GauriK58/Audio-Amplifier-Project/Report_Team9.pdf

# Audio Amplifier Design

Gauri Krishnan
International Institute of Information Technology Hyderabad, India
gauri.krishnan@students.iiit.ac.in 2024102073

Sukeerthi Kattamuri
International Institute of Information Technology Hyderabad, India
sukeerthi.kattamuri@students.iiit.ac.in 2024102074

Abstract—This project presents the design and simulation of a multi-stage audio amplifier capable of amplifying low-level input audio signal. The system is designed to achieve an overall voltage gain of approximately 500 for input signals in the range of 10–20 mV peak-to-peak. The amplifier consists of a differential amplifier used as a pre-amplifier for noise reduction and initial gain, followed by a common emitter stage that provides the majority of the voltage amplification. A bandpass filter is then used to restrict the signal to the human audible frequency range. Finally, a power amplifier stage increases the signal power to effectively drive the load.

I. INTRODUCTION

The primary function of the audio amplifier is to amplify a low-magnitude input audio signal and deliver a sufficiently strong output to drive a speaker. The design specifications require an input signal in the range of 10–20 mV peak-topeak to achieve an overall voltage gain of 500.
To meet this requirement, the amplifier is implemented using multiple stages. The first stage is a differential amplifier that serves as the pre-amplifier. Its main purpose is to reduce noise present at the input while providing an initial level of voltage gain. This improves signal quality before further amplification. The second stage consists of a common emitter (CE) amplifier. This stage provides the majority of the voltage gain required to meet the overall gain specification of 500. After sufficient amplification, the signal is passed through a bandpass filter. This filter restricts the frequency range to the human audible spectrum (20 Hz to 20 kHz), removing unwanted low-frequency and high-frequency components. The final stage is the power amplifier. Its function is to increase the signal power to a level capable of driving the specified load effectively.
Thus our final circuit consists of:
- Mic Circuit
- Pre-Amplifier
- CE Amplifier
- Bandpass Filter
- Power Amplifier
- Speaker
The design specifications are given below:

TABLE I: Audio Amplifier Design Specifications

Parameter | Specification
Input Voltage (Microphone) | 10–20 mV (peak-to-peak)
Input Frequency Range | 20 Hz – 20 kHz
Voltage Gain | 500
Power Output | ≈ 1.5 W
Load Impedance | ≈ 10 Ω

II. MICROPHONE CIRCUIT
The microphone can be modeled as a resistor that changes on the basis of the intensity of the incoming sound. These changes are converted into voltage variations so the resulting signal can be given as input to the pre-amplifier stage.

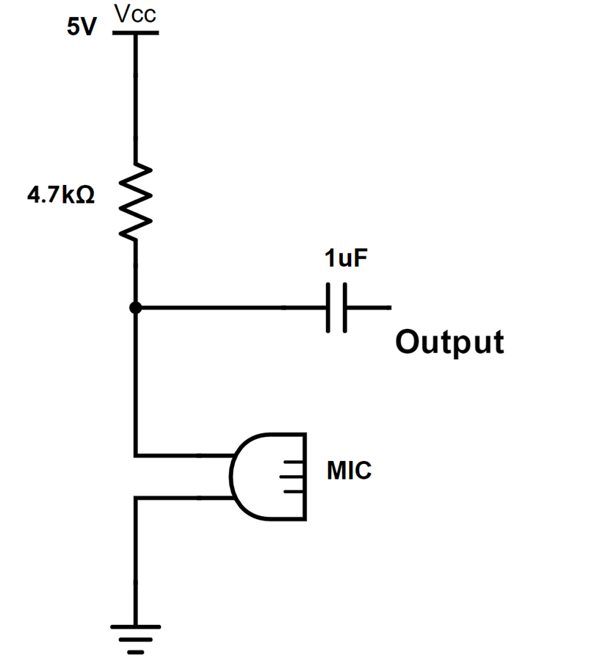
[picture p1: figure]

Fig. 1: Mic Circuit Diagram

III. PRE - AMPLIFIER STAGE The pre-amplifier stage amplifies the difference between two input voltages while suppressing any signal common to both inputs. Since the microphone input signal is very weak, it is highly susceptible to noise. If noise is not removed at this stage, it will continue to be amplified in the subsequent stages. Therefore, the pre-amplifier must provide good noise rejection along with moderate voltage gain.
In our implementation, the input signal is applied to the first transistor of the differential pair, while the second transistor is grounded. This configuration allows for differential operation and improved noise immunity.
A. Gain Derivation
Consider the small-signal model of the BJT differential amplifier. For small-signal operation:

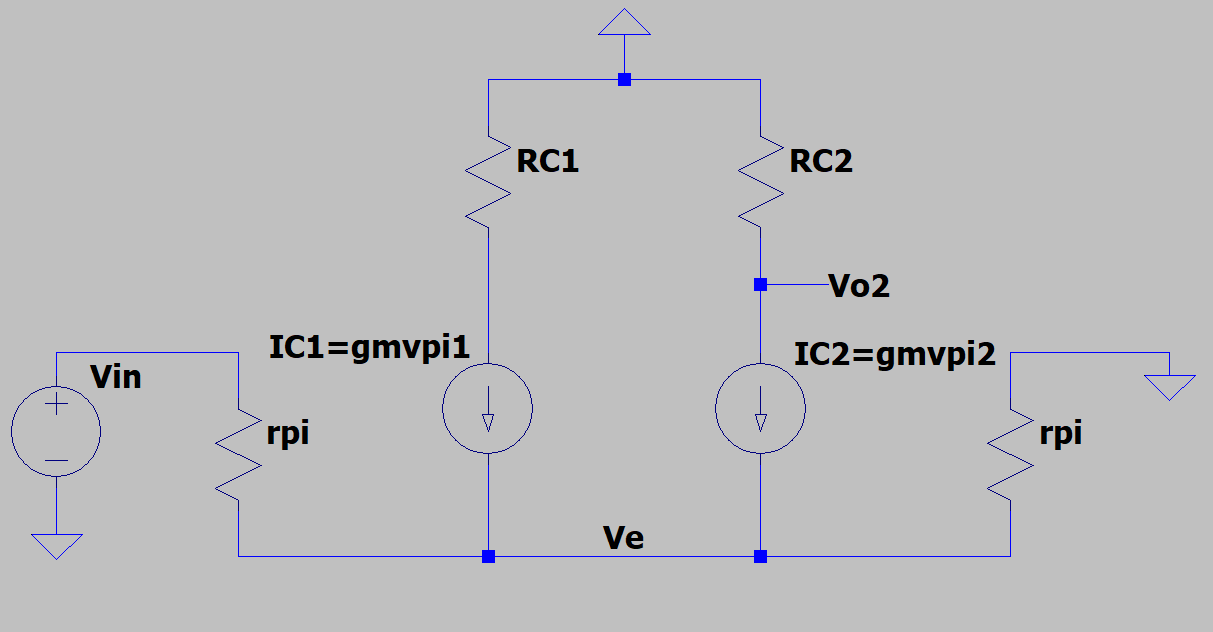
[picture p2: figure]

Fig. 2: Pre-Amplifier Small Signal Model

ic1 = gmvπ1, | ic2 = gmvπ2

From the input loop,

Vin − vπ1 + vπ2 = 0

⇒ Vin = vπ1 − vπ2 | (1)

Applying KCL at the common emitter node:

vπ1
rπ

+

vπ2
rπ

+ gmvπ1 + gmvπ2 = 0
gm +

1
rπ
(vπ1 + vπ2) = 0
⇒ vπ1 = −vπ2 | (2)

The output is taken from one collector:

vo2 = −gmvπ2RC

Using (1) and (2), substitute vπ2 = −

Vin
2

:

⇒ vo2 = gm

Vin
2
RC

Now,
Av =

vo

Vin

=

gmRC
2
Since

re =

1
gm

Av =

RC
2re

If an external emitter resistance RE is added:

Av =

RC
2(re + RE)
B. Target Gain and Parameter Calculation Target gain, Av = 20

We assume:
RC = 5 kΩ

Using DC bias condition:

VCC − IC RC = VCE

Taking:

VCE =

1
2

VCC

IC =

2.5
5 × 10³

= 5 × 10⁻⁴ = 500 µA

Tail current:
IT = 2IC = 1000 µA

Tail resistance:
−RT IT + 5 = 0

RT =

5
1000 µA = 5 kΩ

Small-signal emitter resistance:

re =

VT
IC

≈ 52 Ω

Differential gain:

Ad =

RC
2(re + RE)

Substituting target gain:

20 =

5000
2(52 + RE)

RE = 72 Ω

After iterating values, we end up with RE = 55Ω and RT = 2.15 kΩ

C. Common Mode Rejection Ratio (CMRR)
The performance of the differential amplifier is evaluated using differential gain, common-mode gain, and the Common Mode Rejection Ratio (CMRR). A high CMRR indicates effective suppression of common-mode noise.

a) Theoretical Expressions:
- Differential Gain (Ad) represents the amplification of the difference between the two input voltages.
- Common-mode Gain (Acm) represents the amplification of signals common to both inputs. Ideally, this should be very small.
- Common Mode Rejection Ratio (CMRR) is defined as:

CMRR = 20 log
Ad

Acm

b) Measured Values: The following values were obtained from circuit simulation:
- Differential Gain

Ad =

430.17
20

= 21.5

- Common Mode Gain:

Acm = 2.268

CMRR = 20 log
21.5

2.268
= 19.53 dB

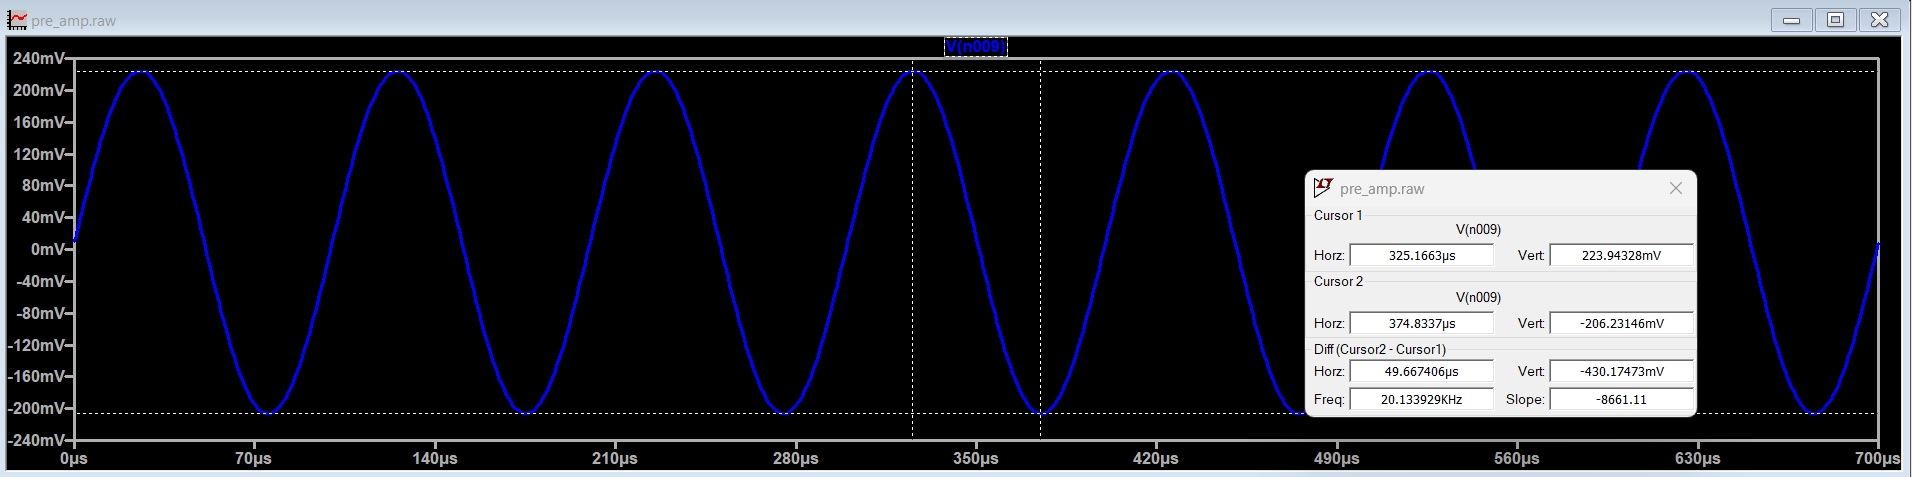
[picture p3: figure]

Fig. 3: Pre-Amp Differential Gain (Ad)

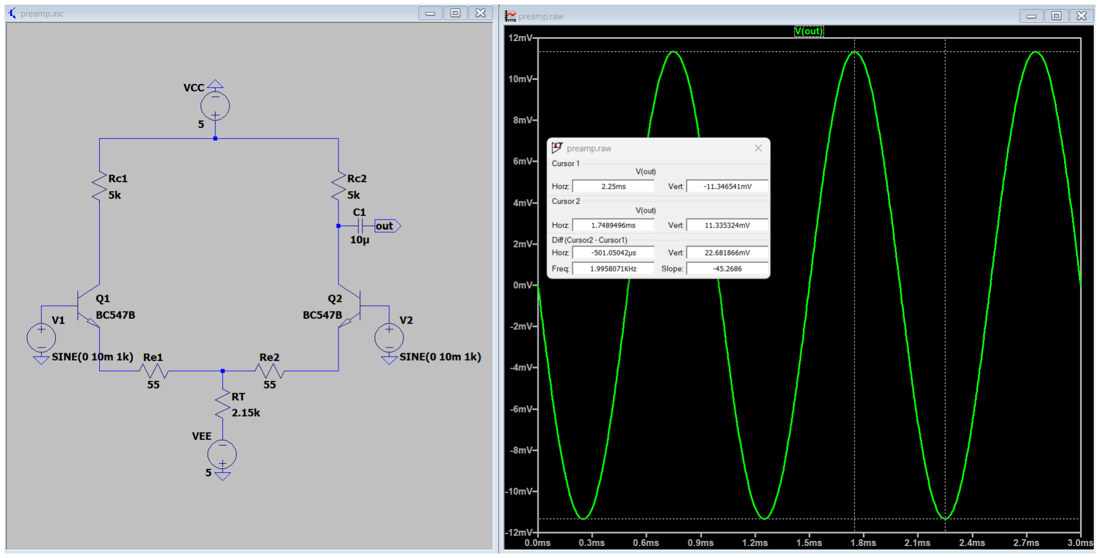
[picture p4: figure]

Fig. 4: Pre-Amp Common Mode Gain(Ac)

D. Input and Output Impedance Analysis

The pre-amplifier should have:

- High input impedence (Rin), so that it does not load the microphone source.
From Fig 14a, input impedence = 1
2.362 = 42.33kΩ
- Low output impedence (Rout), so that it can effectively drive the next stage.
From Fig 14b, output impedence = 1V 200.48µA = 4.9kΩ

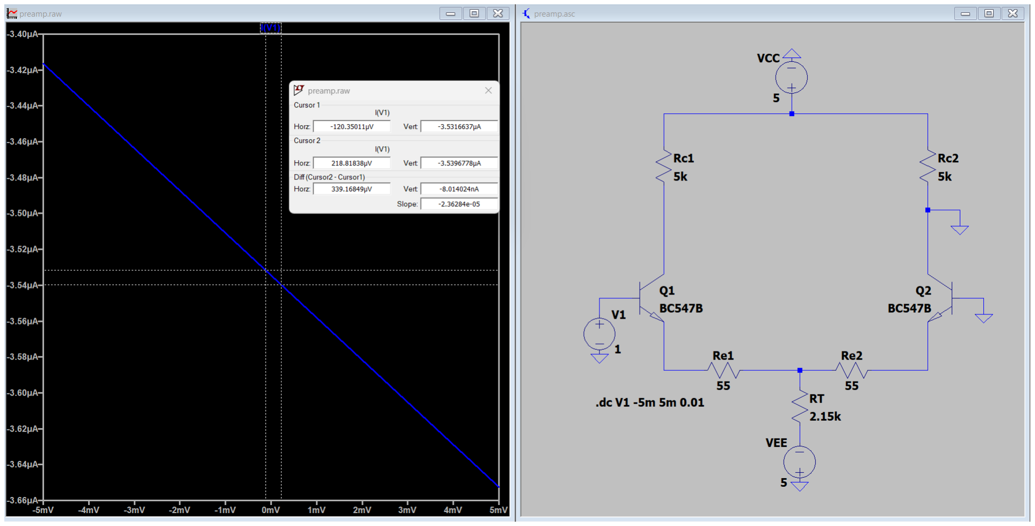
[picture p5: figure]

(a) Input Impedance Measurement

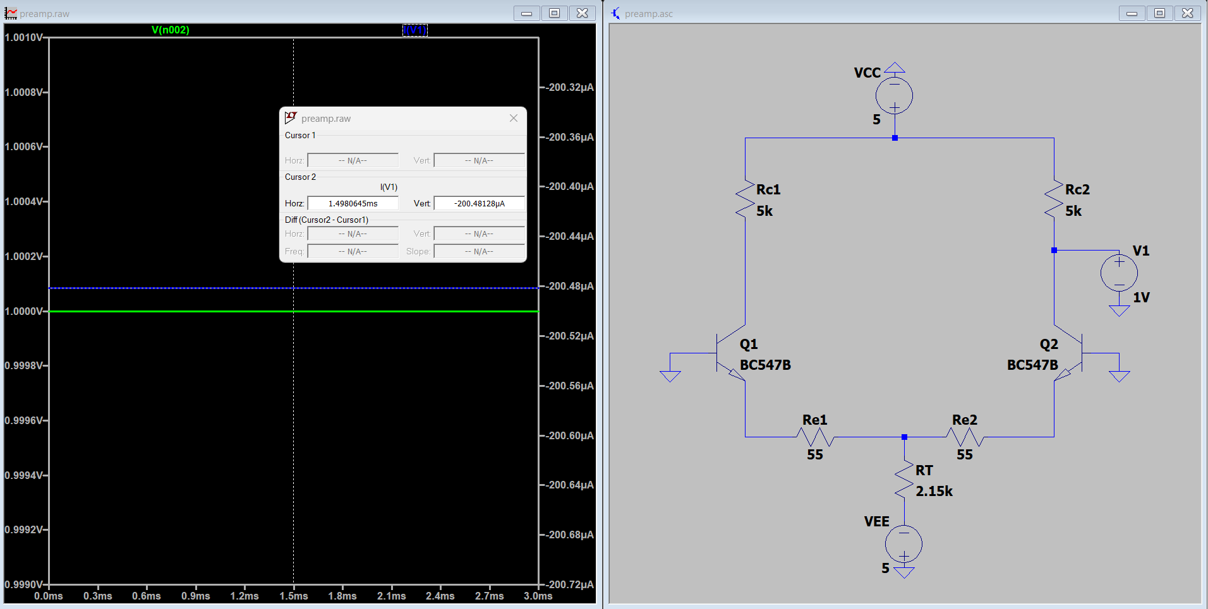
[picture p6: figure]

(b) Output Impedance Measurement

Fig. 5: Pre-amplifier impedance measurements

E. Waveforms

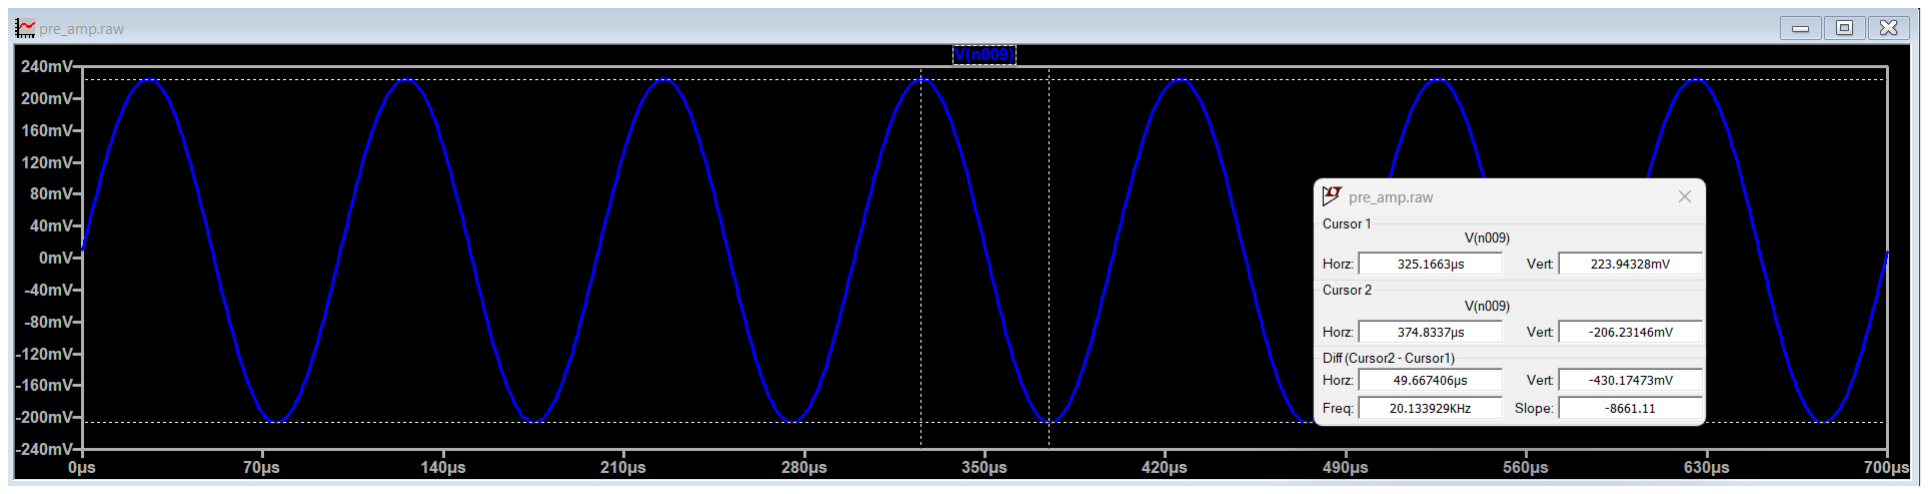
[picture p7: figure]

Fig. 6: Pre-Amp Gain

Fig 7a shows Pre-Amp output in hardware when it is not connected to the rest of the circuit.

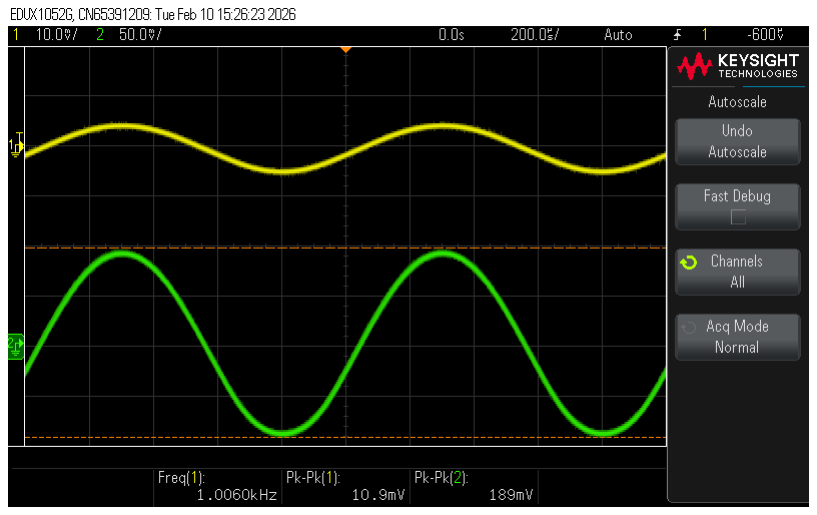
[picture p8: figure]
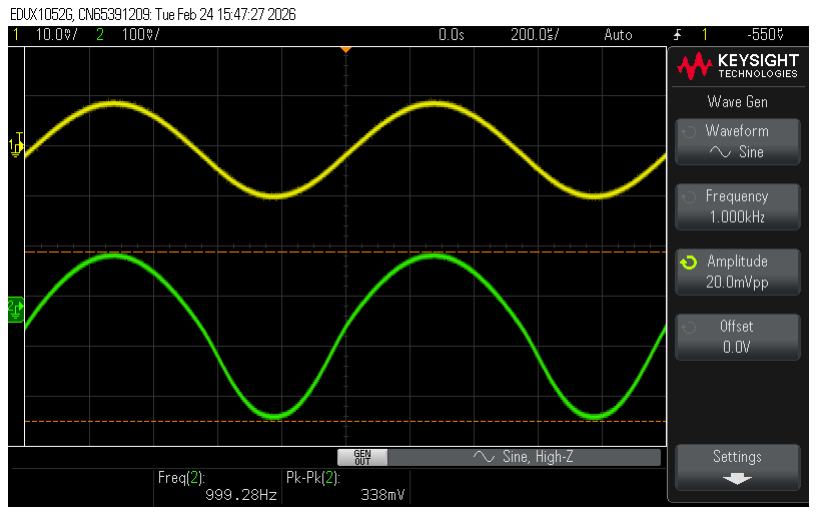
[picture p9: figure]

(a) Output for (for 10mV input) | (b) Output in full circuit

Fig. 7: Pre-amplifier output in hardware

IV. GAIN STAGE

A. Small Signal Gain Calculation

Consider the small-signal model of the CE amplifier.

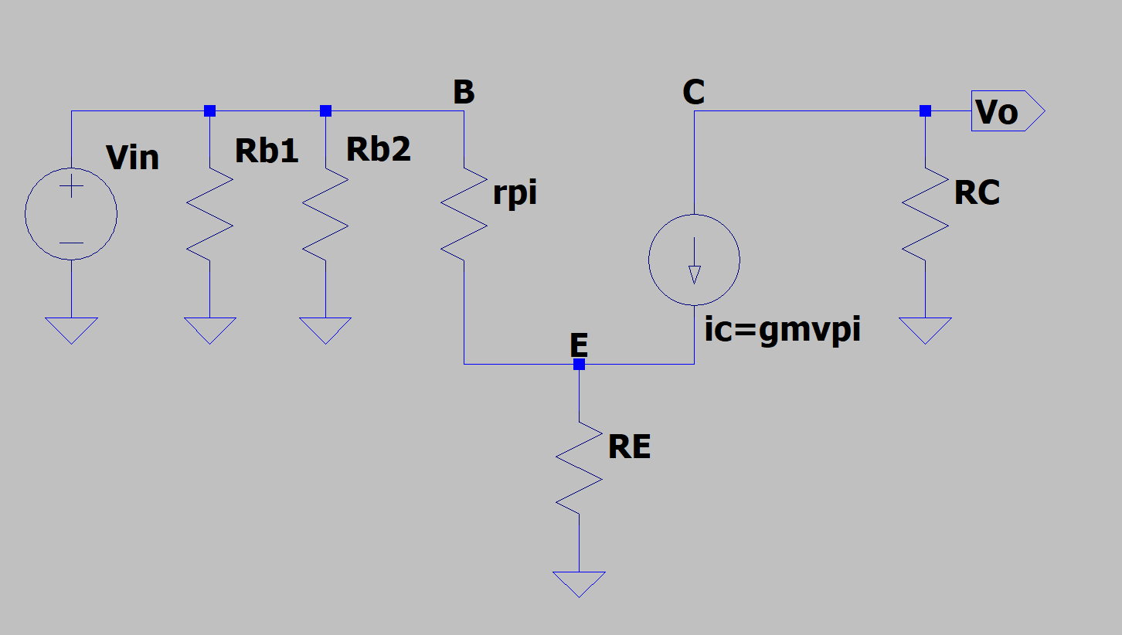
[picture p10: figure]

Fig. 8: CE Small Signal Model

Since the output current flows through the collector resistor,

io = −ic

⇒ vo = −icRC = −gmvπRC | (1)

Applying KVL at the input loop,

vin = vπ + vE

Also,
vE = iERE

Taking iE ≈ iC ,

vin = vπ + icRE = vπ + gmvπRE

⇒ vin = vπ(1 + gmRE)

Thus

vπ =

vin
1 + gmRE

Substituting into equation (1),

vo = −gmRC

vin
1 + gmRE

Therefore the voltage gain is

Av =

vo

vin

=

−gmRC
1 + gmRE

Since

re =

1
gm

⇒ Av = −

RC
re + RE
B. Target Gain and Parameter Calculation
The overall gain requirement of the amplifier is approximately 500. However, because of the 0.6V drop across the BE junction of the transistor, the voltage swing reduces. Achieving a gain of 500 is nearly impossible so we aim for a gain of 450. The pre-amplifier stage already provides a gain of approximately 20 so the CE amplifier stage is designed to provide a gain of about 25 so that the combined gain meets the required specification.

Target gain, Av = 25
We assume RC = 5.6 kΩ

The small signal gain of the CE amplifier is

|Av| =

gmRC
1 + gmRE

Using the relation

gm =

ic
VT

⇒ |Av| =

icRC
VT + icRE

Rearranging,

AvVT + AvicRE = icRC

AvVT = ic(RC − AvRE)

ic =

AvVT
RC − AvRE

(1)

For proper transistor operation, the condition

VC − VE > 0.7V

must be satisfied.
Considering iE ≈ iC ,

VC = VCC − icRC

VE = iERE

Substituting,

VCC − icRC − icRE − VEE > 0.7

10 − ic(RC + RE) > 0.7

9.3 > ic(RC + RE)

Substituting equation (1):

AvVT
RC − AvRE

(RC + RE) < 9.3

Using Av = 25, VT ≈ 26 mV 0.65(5.6k + RE) 5.6k − 25RE

< 9.3

Solving, we obtain

| RE < 207.5 Ω

Now for calculating the values of resistances RB1

and RB2
,
From the gain expression,

Av = 25 =

| 5.6k ic 26 × 10⁻³ + 20ic

25(26 × 10⁻³ + 20ic) = 5600ic

0.650 + 500ic = 5600ic

ic =

0.65
600

≈ 1 mA

Using the base-emitter loop, and taking ie ≈ ic

VB − 0.7 − ieRE + 5 = 0

VB − 0.7 − 0.2 + 5 = 0

VB = −4.1 V

VCC − VB

RB1

=

VB − VEE

RB2

Thus, RB1

: RB2 = 10.11:1 The values we took after trial and error are RB1 = 200kΩ RB2 = 18kΩ
Thus, the initial values taken were RC = 5.6kΩ and RE = 200Ω. However, once we connected the following stages, there was a drop in gain due to loading. To account for this, we increased gain in the CE stage by increasing RC to 7.2kΩ. This induced clipping, and to combat this, we changed RE to 270Ω.

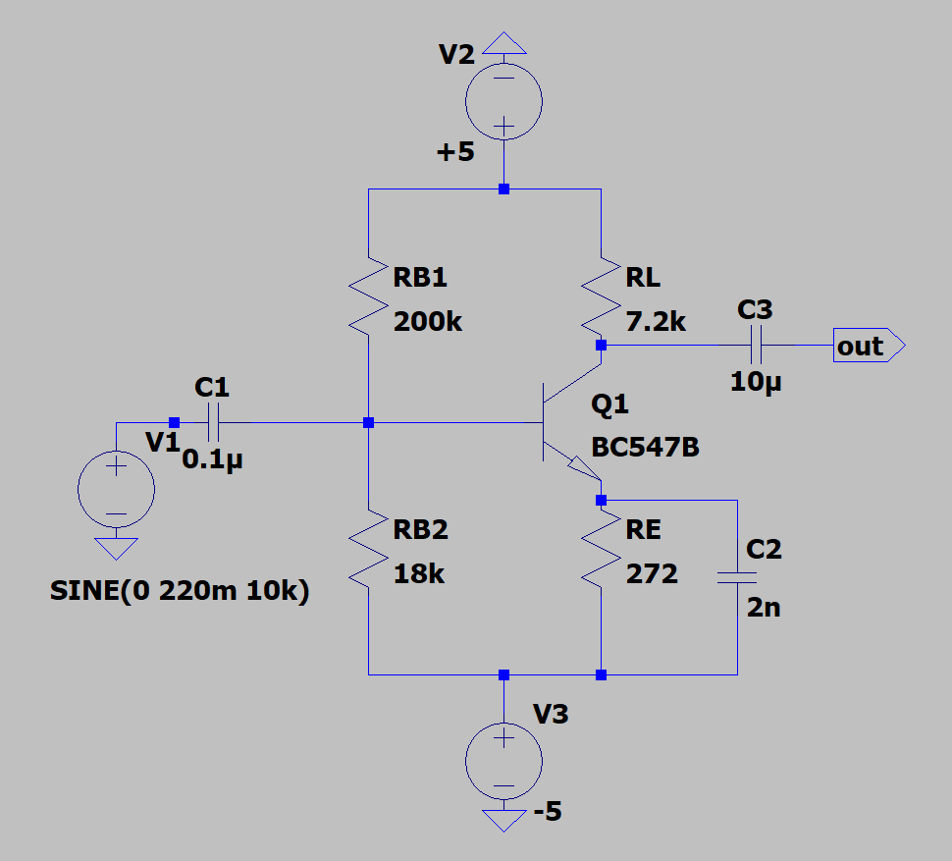
[picture p11: figure]

Fig. 9: CE circuit

C. Biasing Design and Active Region Verification

The base of the transistor is biased using the voltage divider formed by the resistors RB1 and RB2. This voltage divider sets a stable DC bias voltage VB at the base terminal. The chosen resistor values ensure that the base voltage can be fixed at a desired level so that the transistor operates in the correct region.

VB =

VCC RB2 + VEERB1

RB1 + RB2

By plugging in the values, we obtain the bias point in the circuit as −4.17V From the simulations, we measure VC = 0.5V and VE = −4.8V , which shows that the transistors are in the active region of operation.

D. Waveform Verification
1) Simulation: Comparing the gain after CE stage alone and with the full circuit:
2) Hardware: Fig 12 shows the output of CE-Amp in the final circuit (with all stages connected).

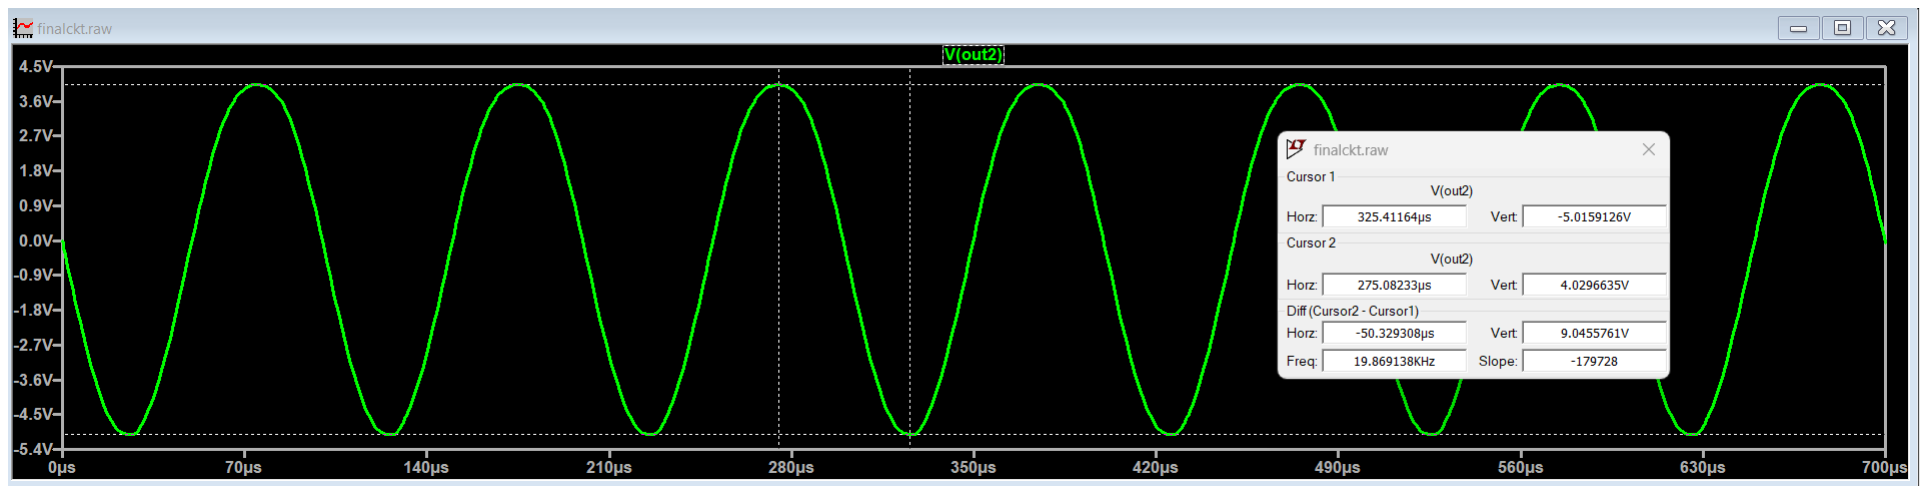
[picture p12: figure]

Fig. 10: PreAmp and Gain stage integration.

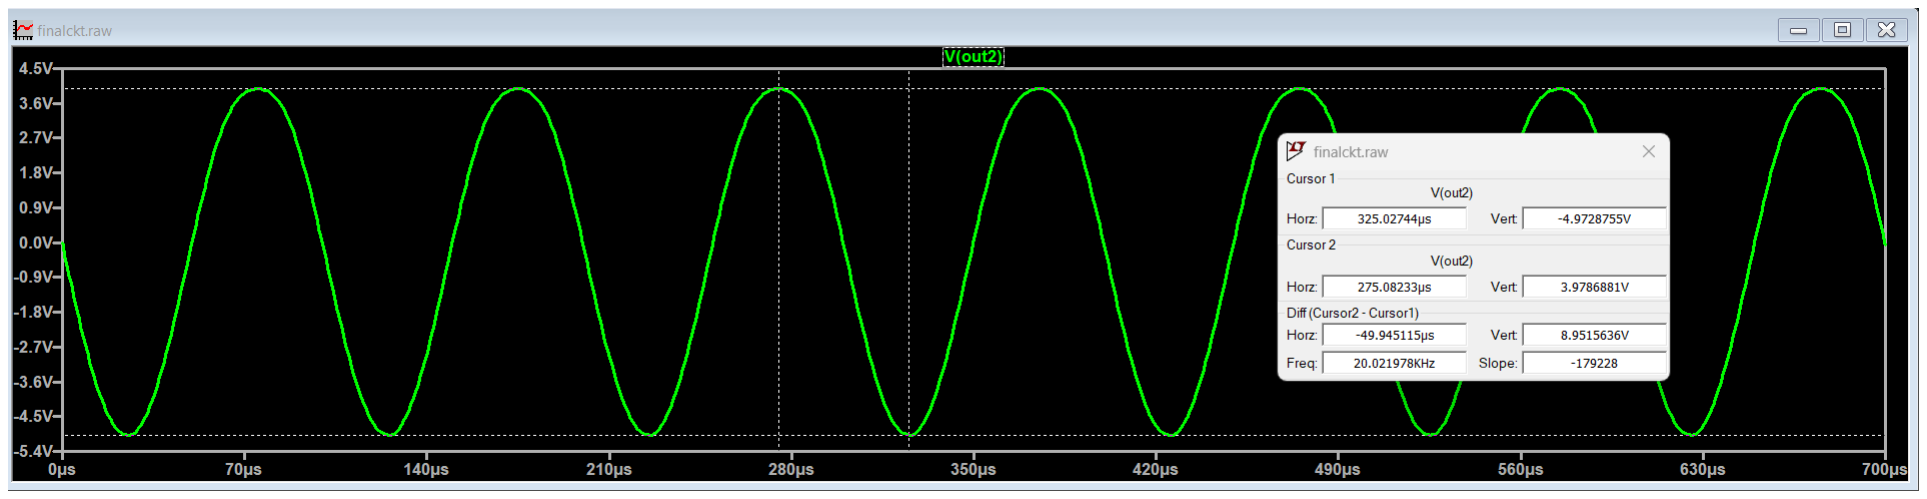
[picture p13: figure]

Fig. 11: PreAmp and CE stage gain with full circuit.

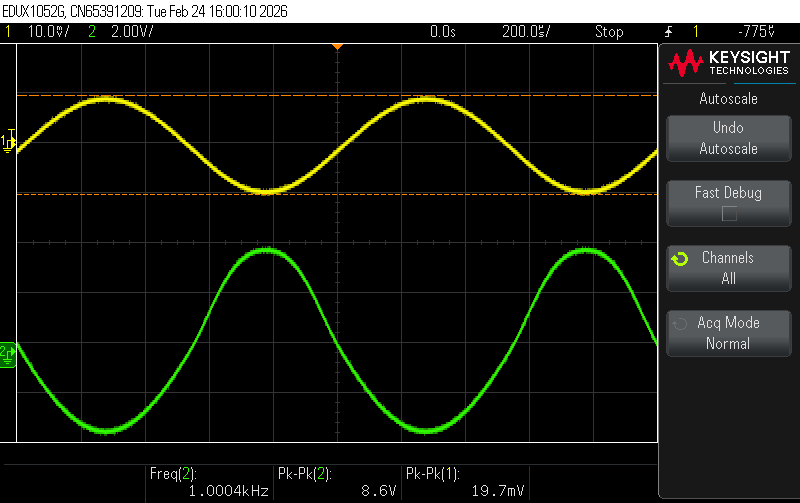
[picture p14: figure]

Fig. 12: Gain after CE stage in the fully connected circuit.

V. FILTER STAGE

The bandpass filter is used to remove noise and unwanted frequency components that lie outside the audible range. The desired passband is from 20 Hz to 20 kHz, ensuring that only frequencies within the human hearing range are allowed to pass while signals outside this range are attenuated. The cutoff frequencies are selected such that there is a small margin around the passband to account for the −3 dB cutoff points of the filter. Although the desired passband of the audio amplifier is the human audible range of 20 Hz to 20 kHz, the filter was designed with cutoff frequencies slightly beyond this range to ensure that there is no attenuation at 20 Hz and 20 kHz. As a result, frequencies near 20 Hz and 20 kHz remain within the flat region of the passband, maintaining consistent audio quality across the desired frequency spectrum.

An active bandpass filter configuration is used in this design, which employs operational amplifiers rather than relying solely on passive components. The use of an active filter provides better control over the gain and allows a sharper and more well-defined frequency response compared to passive bandpass filters.

A. AC Response Derivation

The active bandpass filter is implemented using an operational amplifier in the inverting configuration. The input network (R1, C1) forms the high-pass section, while the feedback network (R2, C2) forms the low-pass section.

Since an ideal op-amp has very high input impedance, no current flows into the input terminals. Therefore, the currents through the input and feedback networks are equal:

Vin − V

−
Z1

=

V

− − Vout
Z2

For an ideal op-amp operating with negative feedback,

V

− = V
+ = 0

Thus,

Vout

Vin

= −

Z2
Z1

The impedances of the input and feedback networks are

Z1 = R1 +

1
sC1

Z2 =

R2
1 + sR2C2

Substituting into the gain expression,

Vout

Vin

= −

R2
1 + sR2C2

·

sC1
sR1C1 + 1

Therefore, the transfer function of the active bandpass filter is

H(s) = Vout

Vin

=

−sR2C1
(1 + sR2C2)(1 + sR1C1)

Letting s = jω,

H(jω) = | −jωR2C1 (1 + jωR2C2)(1 + jωR1C1)

For the midband region where

1
R1C1
| < ω <
| 1 R2C2

the transfer function simplifies to

| Av ≈ − R2 R1

Since the filter stage is designed to have unity gain,

| R2 = R1

From the simulation, the lower cutoff frequency is approximately 9.5 Hz and the upper cutoff frequency is approximately 38.4 kHz, corresponding to the −3 dB points.

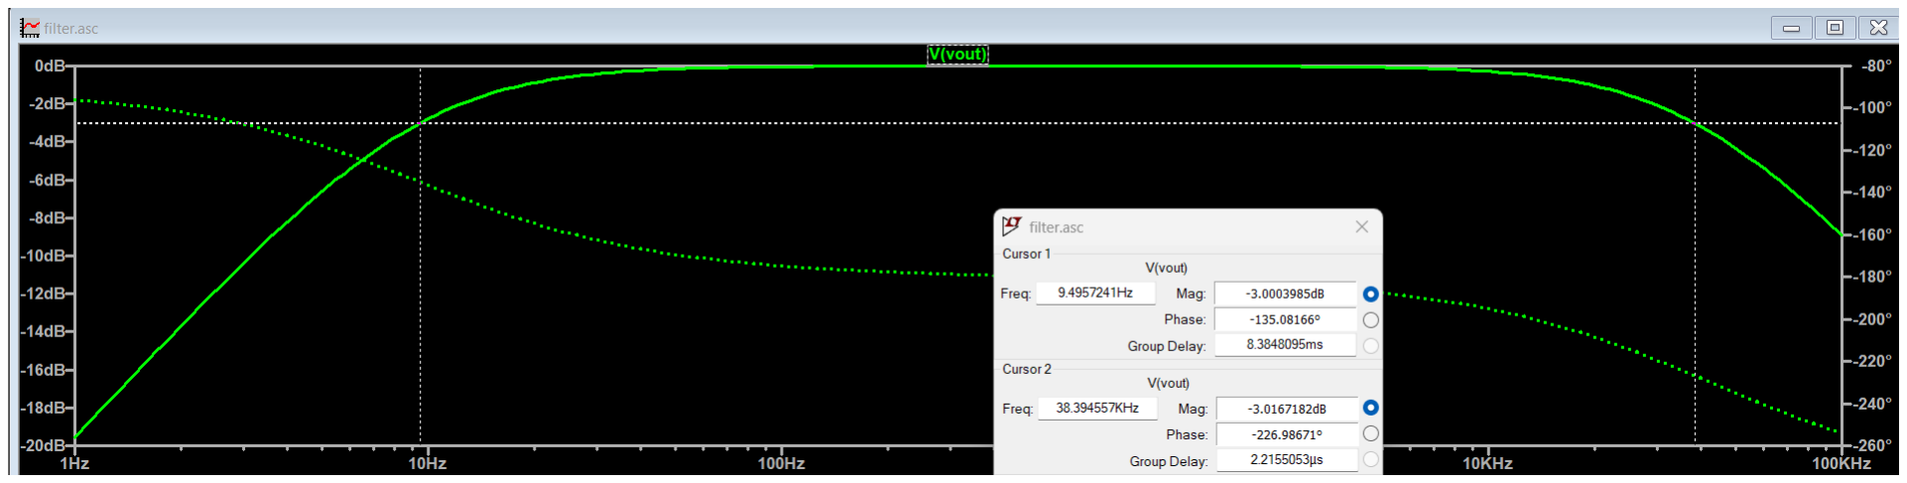
[picture p15: figure]

Fig. 13: 0dB Gain of Filter

B. Plots

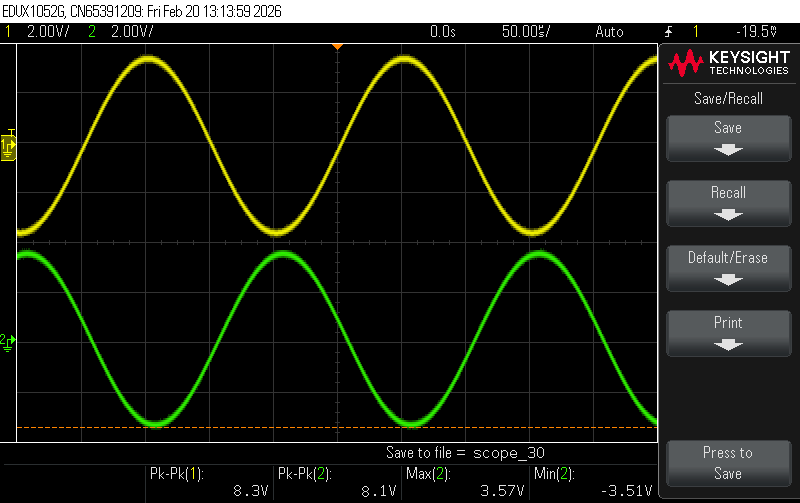
[picture p16: figure]
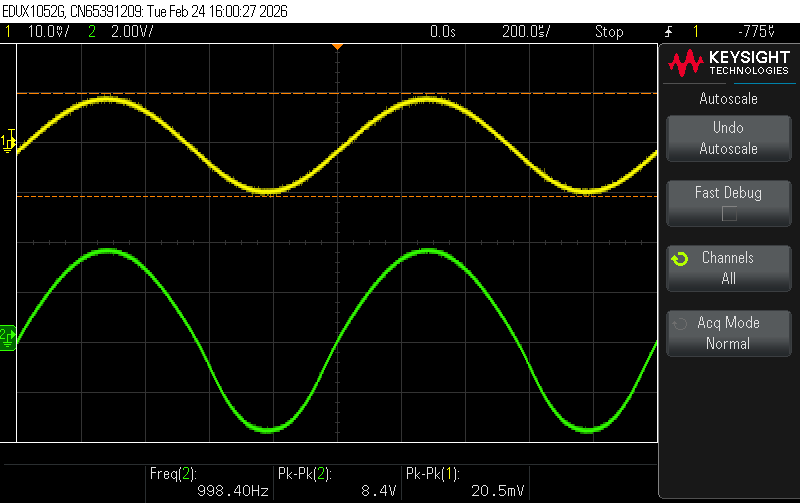
[picture p17: figure]

(a) Output of Filter Stage alone | (b) Output in full circuit

Fig. 14: Pre-amplifier output in hardware

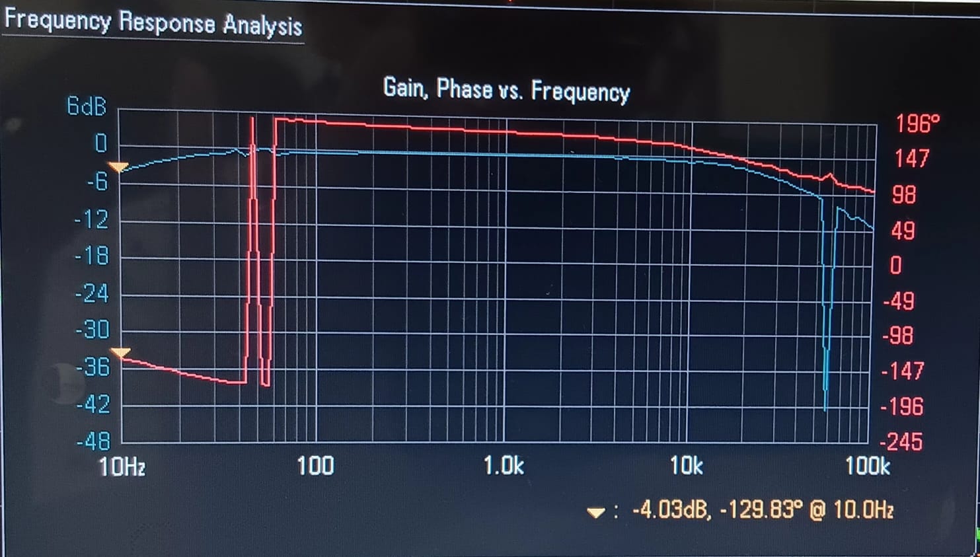
[picture p18: figure]

Fig. 15: Bodeplot showing 0dB gain (Hardware)

VI. POWER AMPLIFIER

A. Class AB Configuration and Biasing

A Class AB power amplifier is used in the final stage to provide sufficient current after the filter stage to drive the speaker load. AB configuration is chosen is because it combines the advantages of both class A and B configurations.

Class A has low distortion but high power dissipation since the transistor is conducting throughout. Class B amplifiers on the other hand, save power since they conduct only during the positive half of the cycle, but result in crossover distortion during the period when both the transistors are off. To solve these, class AB amplifier removes this distortion by slightly biasing both transistors so that they conduct for a little more than half of the cycle.

Power transistors TIP31C and TIP32C are used for more tolerance. To ensure that the bases of the transistors are biased such that remain slightly forward biased, diodes are used since they have a voltage drop of about 0.7 V when they are forward biased.
By placing diodes in the biasing path, a nearly constant voltage difference is established between the bases of the two transistors. As a result, the transition between the positive and negative halves of the signal is smooth, which eliminates crossover distortion in the output.
B. Unity Gain
Considering the small signal emitter resistance re and load resistance RL, Av =

RL
RL+re
Since RL ≫ re, Av ≈ 1.
C. Parameter Values
The two biasing resistors ensure that the transistors are slightly forward biased, which helps prevent crossover distortion in the output stage. The capacitors act as AC coupling capacitors that block any DC offsets while allowing the AC signal to pass to the next stage. The values are chosen based on the high-pass cutoff frequency given by fc =

1
2πRC where R is the effective input resistance seen by the capacitor and C is the coupling capacitor value.

Initially, the resistor values were chosen as 1 kΩ. However, this caused loading on the power supply during the hardware implementation. This occurred because the resistors form a current path between the supply rails through the diode biasing network. With such low resistance values, a relatively large current flows through this path, resulting in excessive current draw from the power supply. When the resistor values were increased to 4.7 kΩ, the bias current decreased, preventing the power supply from overloading while still maintaining the required biasing conditions. This was the final resistance value used in the hardware circuit.

The selected capacitor value of 0.2 µF ensures that the audio signal passes through the stage without significant attenuation while maintaining stable DC biasing of the circuit. Equal values were used for the resistors and capacitors in both branches to maintain symmetrical biasing and ensure equal amplification during the positive and negative half cycles of the signal.

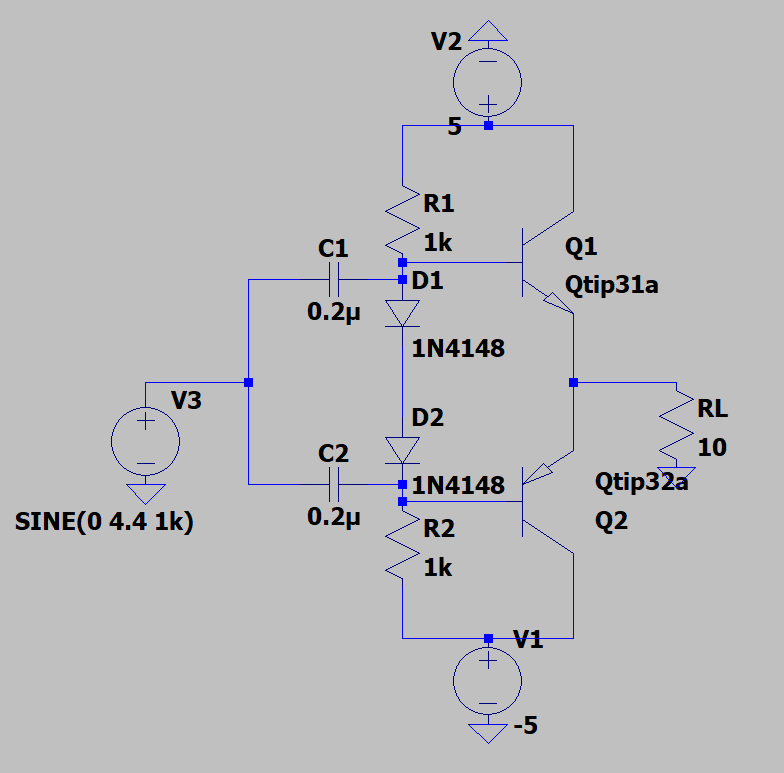
[picture p19: figure]

Fig. 16: Power Amp Circuit

D. Power Output Calculation
The output power delivered to the load can be calculated using

P =

V

2
rms
Rload

=

V

2
peak
2Rload
Substituting the values:

Vrms = 4.5 V, Rload = 10 Ω

P =

4.5

2
20

P = 1.012 W

Therefore, the output power delivered to the 10 Ω load is approximately 1.012 W.

E. Waveform Verification

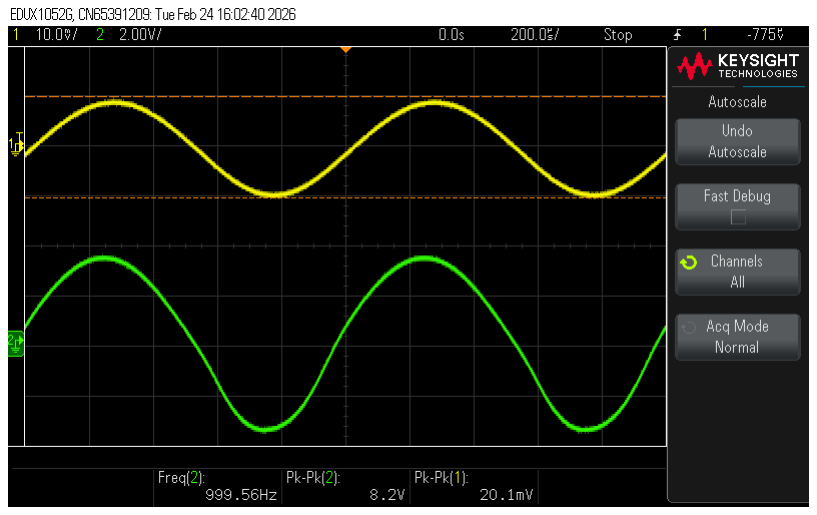
[picture p20: figure]

Fig. 17: PowerAmp output in full circuit.

VII. OVERALL PERFORMANCE

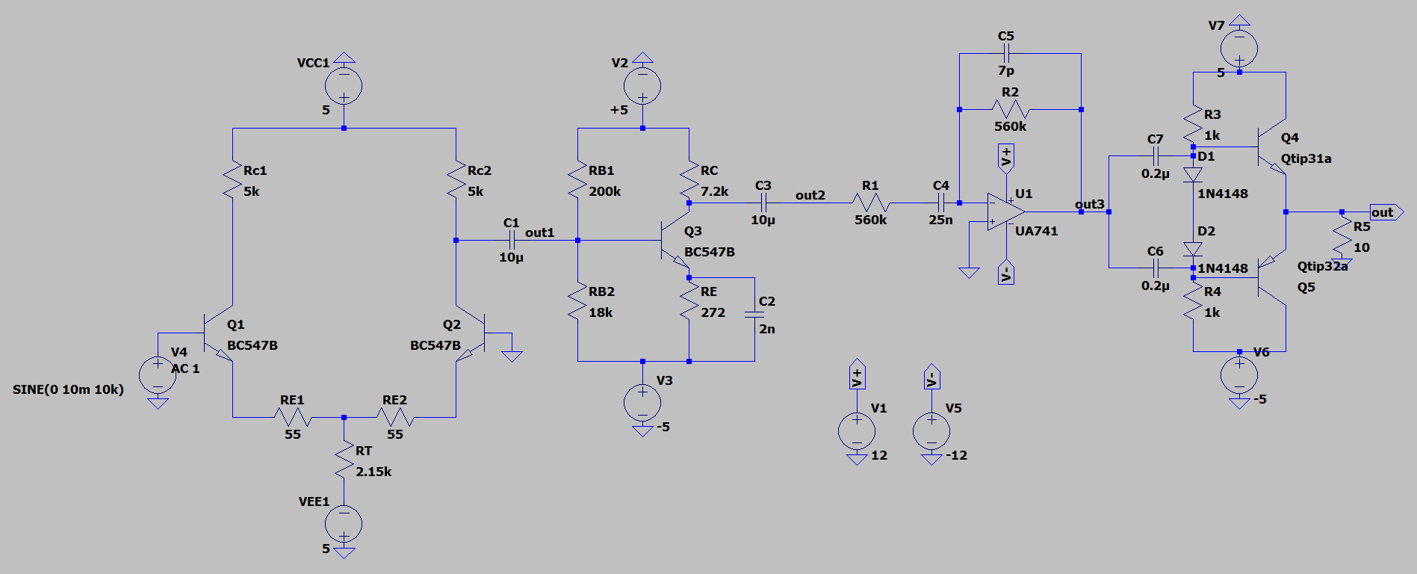
[picture p21: figure]

Fig. 18: Final Circuit (Simulation)

A. Overall Gain
1) Tran: From the Simulation, we obtained a Gain of 430.5.

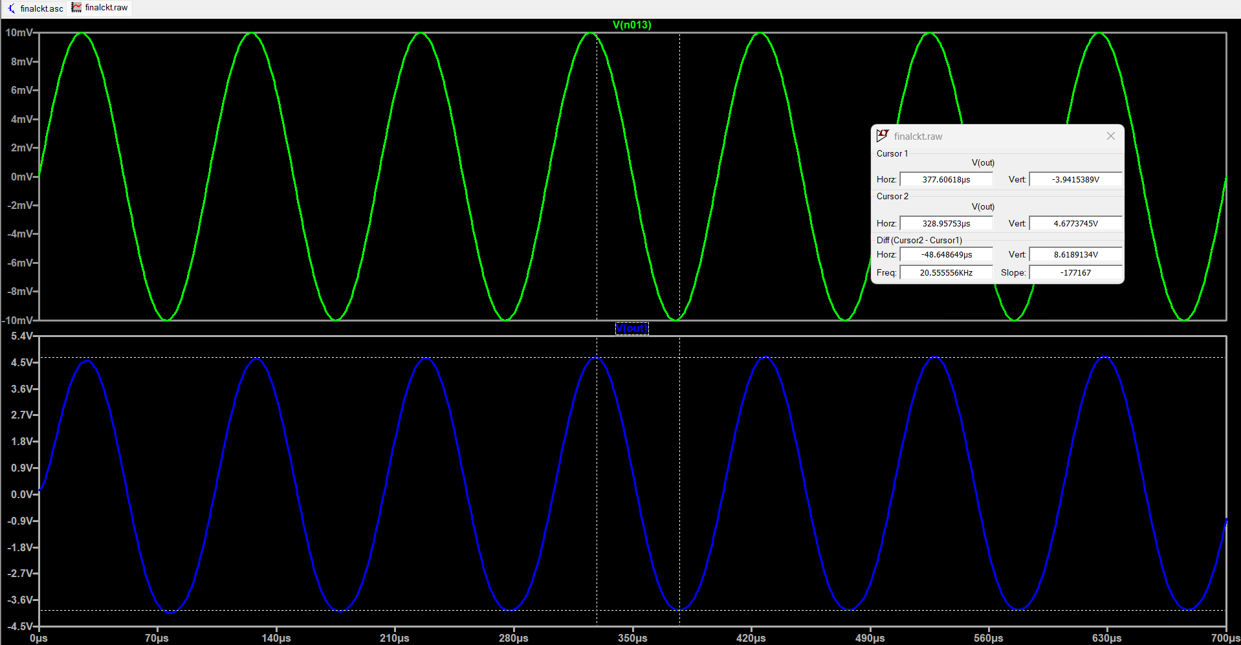
[picture p22: figure]

Fig. 19: Final Circuit Gain (Simulation)

Finally, we obtained a Gain of 410 in our hardware circuit.

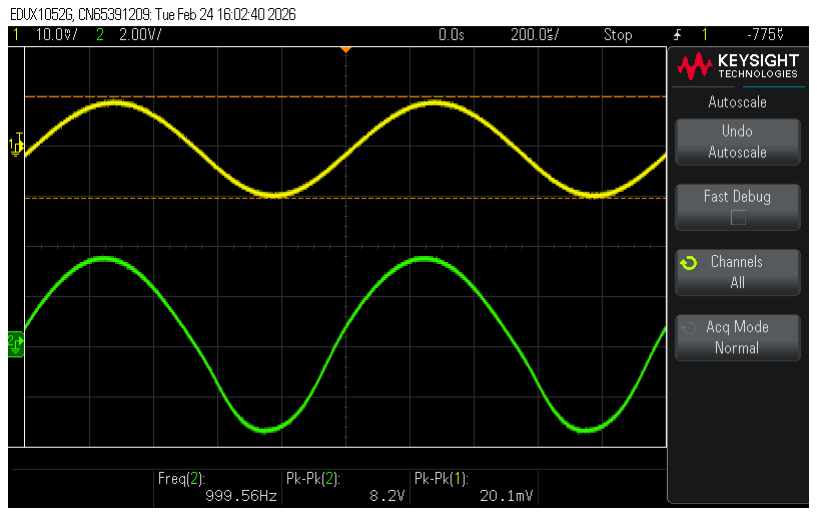
[picture p23: figure]

Fig. 20: Final Circuit Gain (Hardware)

2) AC analysis: Fig 21 and Fig 22 show the final bode plot obtained in Simulation and Hardware respectively.

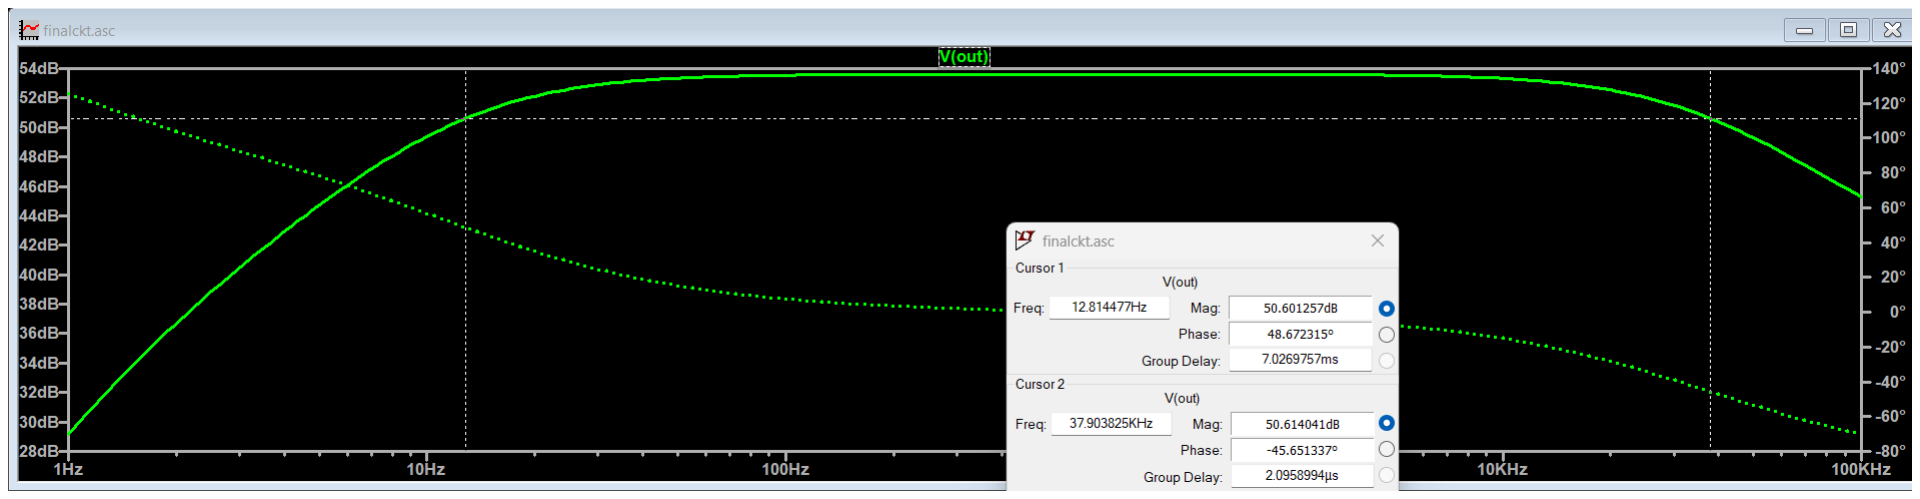
[picture p24: figure]

Fig. 21: Final Bodeplot

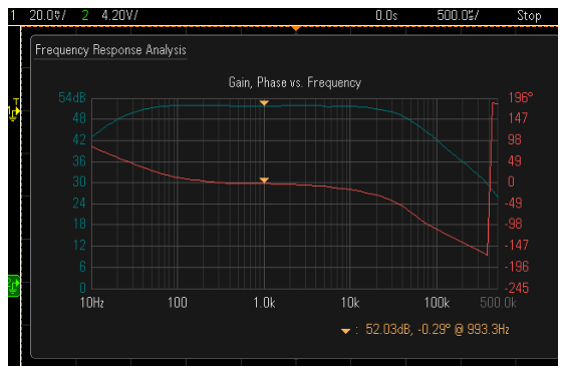
[picture p25: figure]

Fig. 22: Final Circuit Bode Plot

B. Total Harmonic Distortion

T HD =

qP∞
n=2 V

2
n,RMS

Vf,RMS

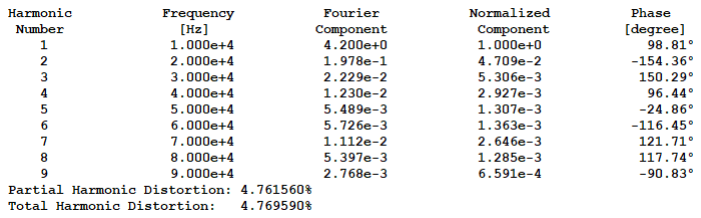
[picture p26: figure]

Fig. 23: THD

C. Slew Rate
The slew rate of the amplifier is calculated from the slope of the output waveform:

SR =

∆V
∆t
From the LTspice cursor measurements,

∆V = −1.898536 V, ∆t = 3.4735023 µs

SR =

−1.898536
3.4735023

SR ≈ 0.546 V/µs

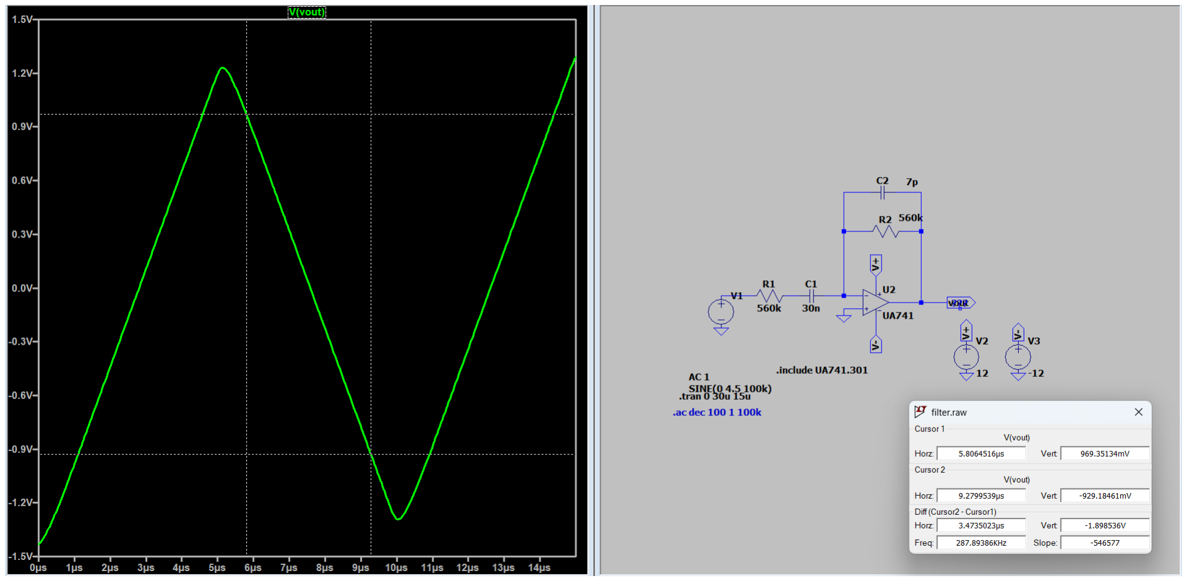
[picture p27: figure]

Fig. 24: Slew Rate

REFERENCES

[1] ”RF Electronics”, by Behzad Razavi
[2] ”Microelectronic Circuits”, by Kenneth Smith, Adel Sedra
[3] ”Differential Amplifier - The Voltage Subtractor,” Electronics Tutorials.[Online].
[4] ”Common Emitter Amplifier and Bipolar Transistor CE Amplifiers,”Electronics Tutorials. [Online].
[5] “Band Pass Filter and Bandstop Filter Explained,” YouTube, uploaded by All About Electronics, Sep. 3, 2017. [Online].
[6] ”Transistor Amplifiers - Class A, AB, B, C Circuits,” The Organic Chemistry Tutor. [Online].
