GauriK58/Audio-Amplifier-Project/Simulations/ce.asc

C1: cap; 0.1µ
C2: cap; 2n
C3: cap; 10µ
Q1: npn; BC547B
RB1: res; 200k
RB2: res; 18k
RE: res; 272
RL: res; 7.2k
V1: voltage; SINE(0 220m 10k)
V2: voltage; +5
V3: voltage; -5
Named nets: out, 0
.tran 0.5m
.include TSMC_180nm.txt
