GauriK58/Audio-Amplifier-Project/Simulations/filter.asc

C1: cap; 30n
C2: cap; 7p
R1: res; 560k
R2: res; 560k
U2: opamp2; UA741
V1: voltage; SINE(0 4.5 100k); AC 1
V2: voltage; 12
V3: voltage; -12
Named nets: 0, V+, V-, vout
.ac dec 100 1 100k
.tran 0 30u 15u
.include UA741.301
