GauriK58/Audio-Amplifier-Project/Simulations/finalckt.asc

C1: cap; 10µ
C2: cap; 2n
C3: cap; 10µ
C4: cap; 25n
C5: cap; 7p
C6: cap; 0.2µ
C7: cap; 0.2µ
D1: diode; 1N4148
D2: diode; 1N4148
Q1: npn; BC547B
Q2: npn; BC547B
Q3: npn; BC547B
Q4: npn; Qtip31a
Q5: pnp; Qtip32a
R1: res; 560k
R2: res; 560k
R3: res; 1k
R4: res; 1k
R5: res; 10
RB1: res; 200k
RB2: res; 18k
Rc1: res; 5k
Rc2: res; 5k
RC: res; 7.2k
RE1: res; 55
RE2: res; 55
RE: res; 272
RT: res; 2.15k
U1: opamp2; UA741
V1: voltage; 12
V2: voltage; +5
V3: voltage; -5
V4: voltage; SINE(0 10m 10k); AC 1
V5: voltage; -12
V6: voltage; -5
V7: voltage; 5
VCC1: voltage; 5
VEE1: voltage; 5
Named nets: 0, V+, V-, out, out3, out1, out2
.tran 0 0.5m
.include TSMC_180nm.txt
.ac dec 100 1 100k
.include UA741.301
.meas tran Vpp pp V(out)
.meas tran Vpp3 pp V(out3)
.meas tran Vpp2 pp V(out2)
.meas tran Vpp1 pp V(out1)
.include tip31a.lib
.include tip32a.lib
.step param R 415 430 1
.four 10k V(out)
.meas SR MAX deriv(V(out))
