GauriK58/Audio-Amplifier-Project/Simulations/power_amp.asc

C1: cap; 0.2µ
C2: cap; 0.2µ
D1: diode; 1N4148
D2: diode; 1N4148
Q1: npn; Qtip31a
Q2: pnp; Qtip32a
R1: res; 1k
R2: res; 1k
RL: res; 10
V1: voltage; -5
V2: voltage; 5
V3: voltage; SINE(0 4.4 1k)
Named nets: 0
.include tip31a.lib
.include tip32a.lib
.tran 10ms
.step param R 1k 100k 10k
