GauriK58/Audio-Amplifier-Project/Simulations/preamp.asc

Q1: npn; BC547B
Q2: npn; BC547B
Rc1: res; 5k
Rc2: res; 5k
Re1: res; 55
Re2: res; 55
RT: res; 2.15k
V1: voltage; 1
VCC: voltage; 5
VEE: voltage; 5
Named nets: 0
.include TSMC_180nm.txt
.tran 3m
.dc V1 -5m 5m 0.01
